nour-massri/fpga-bpf/README.md

# 6.2050 Fall 2025 Final Project

TODO:

- Add video link + pictures
- Summarize the pdf write-up into a readme
- Clean up testsing framework
- Fully pipelined bpf cpu with full capabilities
