nour-massri/fpga-bpf/sim/ultimate_test_pass_clause_1.txt

00
11
22
33
44
55
66
77
88
99
aa
bb
08
00
45
00
00
30
00
01
00
00
40
06
b7
e3
0a
1d
cb
84
0a
44
39
28
30
39
01
bb
00
00
00
01
00
00
00
00
50
02
72
10
00
00
00
00
aa
bb
cc
dd
01
01
02
03
04
