nour-massri/fpga-bpf/xdc/top_level.xdc

# clk_100mhz is from the 100 MHz oscillator on Urbana Boad

set_property -dict {PACKAGE_PIN N15 IOSTANDARD LVCMOS33} [get_ports {clk_100mhz}]
create_clock -add -name gclk -period 10.000 -waveform {0 4} [get_ports {clk_100mhz}]

# Set Bank 0 voltage
#set_property CFGBVS VCCO [current_design]
#set_property CONFIG_VOLTAGE 3.3 [current_design]
# new for week 6: avoid having Vivado freak out about clock domain crossing!

# set_max_delay -datapath_only 6 -from  [get_clocks clk_pixel_cw_hdmi] -to [get_clocks clk_50mhz_unbuf]
# set_max_delay -datapath_only 6 -from  [get_clocks clk_50mhz_unbuf] -to [get_clocks clk_pixel_cw_hdmi]


# USER GREEN LEDS
set_property -dict {PACKAGE_PIN C13  IOSTANDARD LVCMOS33} [ get_ports {led[0]} ]
set_property -dict {PACKAGE_PIN C14  IOSTANDARD LVCMOS33} [ get_ports {led[1]} ]
set_property -dict {PACKAGE_PIN D14  IOSTANDARD LVCMOS33} [ get_ports {led[2]} ]
set_property -dict {PACKAGE_PIN D15  IOSTANDARD LVCMOS33} [ get_ports {led[3]} ]
set_property -dict {PACKAGE_PIN D16  IOSTANDARD LVCMOS33} [ get_ports {led[4]} ]
set_property -dict {PACKAGE_PIN F18  IOSTANDARD LVCMOS33} [ get_ports {led[5]} ]
set_property -dict {PACKAGE_PIN E17  IOSTANDARD LVCMOS33} [ get_ports {led[6]} ]
set_property -dict {PACKAGE_PIN D17  IOSTANDARD LVCMOS33} [ get_ports {led[7]} ]
set_property -dict {PACKAGE_PIN C17  IOSTANDARD LVCMOS33} [ get_ports {led[8]} ]
set_property -dict {PACKAGE_PIN B18  IOSTANDARD LVCMOS33} [ get_ports {led[9]} ]
set_property -dict {PACKAGE_PIN A17  IOSTANDARD LVCMOS33} [ get_ports {led[10]} ]
set_property -dict {PACKAGE_PIN B17  IOSTANDARD LVCMOS33} [ get_ports {led[11]} ]
set_property -dict {PACKAGE_PIN C18  IOSTANDARD LVCMOS33} [ get_ports {led[12]} ]
set_property -dict {PACKAGE_PIN D18  IOSTANDARD LVCMOS33} [ get_ports {led[13]} ]
set_property -dict {PACKAGE_PIN E18  IOSTANDARD LVCMOS33} [ get_ports {led[14]} ]
set_property -dict {PACKAGE_PIN G17  IOSTANDARD LVCMOS33} [ get_ports {led[15]} ]


set_property -dict {PACKAGE_PIN C9 IOSTANDARD LVCMOS33} [get_ports {rgb0[0]}];
set_property -dict {PACKAGE_PIN A9 IOSTANDARD LVCMOS33} [get_ports {rgb0[1]}];
set_property -dict {PACKAGE_PIN A10 IOSTANDARD LVCMOS33} [get_ports {rgb0[2]}];
set_property -dict {PACKAGE_PIN A11 IOSTANDARD LVCMOS33} [get_ports {rgb1[0]}];
set_property -dict {PACKAGE_PIN C10 IOSTANDARD LVCMOS33} [get_ports {rgb1[1]}];
set_property -dict {PACKAGE_PIN B11 IOSTANDARD LVCMOS33} [get_ports {rgb1[2]}];

## USER PUSH BUTTON
set_property -dict {PACKAGE_PIN J2  IOSTANDARD LVCMOS33} [ get_ports "btn[0]" ]
set_property -dict {PACKAGE_PIN J1  IOSTANDARD LVCMOS33} [ get_ports "btn[1]" ]
set_property -dict {PACKAGE_PIN G2  IOSTANDARD LVCMOS33} [ get_ports "btn[2]" ]
set_property -dict {PACKAGE_PIN H2  IOSTANDARD LVCMOS33} [ get_ports "btn[3]" ]

## USER SLIDE SWITCH
set_property -dict {PACKAGE_PIN G1  IOSTANDARD LVCMOS33} [ get_ports "sw[0]" ]
set_property -dict {PACKAGE_PIN F2  IOSTANDARD LVCMOS33} [ get_ports "sw[1]" ]
set_property -dict {PACKAGE_PIN F1  IOSTANDARD LVCMOS33} [ get_ports "sw[2]" ]
set_property -dict {PACKAGE_PIN E2  IOSTANDARD LVCMOS33} [ get_ports "sw[3]" ]
set_property -dict {PACKAGE_PIN E1  IOSTANDARD LVCMOS33} [ get_ports "sw[4]" ]
set_property -dict {PACKAGE_PIN D2  IOSTANDARD LVCMOS33} [ get_ports "sw[5]" ]
set_property -dict {PACKAGE_PIN D1  IOSTANDARD LVCMOS33} [ get_ports "sw[6]" ]
set_property -dict {PACKAGE_PIN C2  IOSTANDARD LVCMOS33} [ get_ports "sw[7]" ]
set_property -dict {PACKAGE_PIN B2  IOSTANDARD LVCMOS33} [ get_ports "sw[8]" ]
set_property -dict {PACKAGE_PIN A4  IOSTANDARD LVCMOS33} [ get_ports "sw[9]" ]
set_property -dict {PACKAGE_PIN A5  IOSTANDARD LVCMOS33} [ get_ports "sw[10]" ]
set_property -dict {PACKAGE_PIN A6  IOSTANDARD LVCMOS33} [ get_ports "sw[11]" ]
set_property -dict {PACKAGE_PIN C7  IOSTANDARD LVCMOS33} [ get_ports "sw[12]" ]
set_property -dict {PACKAGE_PIN A7  IOSTANDARD LVCMOS33} [ get_ports "sw[13]" ]
set_property -dict {PACKAGE_PIN B7  IOSTANDARD LVCMOS33} [ get_ports "sw[14]" ]
set_property -dict {PACKAGE_PIN A8  IOSTANDARD LVCMOS33} [ get_ports "sw[15]" ]

## USER SEVEN SEGMENT DISPLAY HIGH SIDE DRIVE ACTIVE LOW
set_property -dict {PACKAGE_PIN B3  IOSTANDARD LVCMOS33} [ get_ports "ss0_an[0]"]
set_property -dict {PACKAGE_PIN C3  IOSTANDARD LVCMOS33} [ get_ports "ss0_an[1]"]
set_property -dict {PACKAGE_PIN H6  IOSTANDARD LVCMOS33} [ get_ports "ss0_an[2]"]
set_property -dict {PACKAGE_PIN G6  IOSTANDARD LVCMOS33} [ get_ports "ss0_an[3]"]

set_property -dict {PACKAGE_PIN H5  IOSTANDARD LVCMOS33} [ get_ports "ss1_an[0]"]
set_property -dict {PACKAGE_PIN F5  IOSTANDARD LVCMOS33} [ get_ports "ss1_an[1]"]
set_property -dict {PACKAGE_PIN E3  IOSTANDARD LVCMOS33} [ get_ports "ss1_an[2]"]
set_property -dict {PACKAGE_PIN E4  IOSTANDARD LVCMOS33} [ get_ports "ss1_an[3]"]

## USER SEVEN SEGMENT DISPLAY LOW SIDE DRIVE ACTIVE LOW
set_property -dict {PACKAGE_PIN E6  IOSTANDARD LVCMOS33} [ get_ports "ss0_c[0]"]
set_property -dict {PACKAGE_PIN B4  IOSTANDARD LVCMOS33} [ get_ports "ss0_c[1]"]
set_property -dict {PACKAGE_PIN D5  IOSTANDARD LVCMOS33} [ get_ports "ss0_c[2]"]
set_property -dict {PACKAGE_PIN C5  IOSTANDARD LVCMOS33} [ get_ports "ss0_c[3]"]
set_property -dict {PACKAGE_PIN D7  IOSTANDARD LVCMOS33} [ get_ports "ss0_c[4]"]
set_property -dict {PACKAGE_PIN D6  IOSTANDARD LVCMOS33} [ get_ports "ss0_c[5]"]
set_property -dict {PACKAGE_PIN C4  IOSTANDARD LVCMOS33} [ get_ports "ss0_c[6]"]
# set_property -dict {PACKAGE_PIN B5  IOSTANDARD LVCMOS33} [ get_ports "ss0_cdp"]

set_property -dict {PACKAGE_PIN F3  IOSTANDARD LVCMOS33} [ get_ports "ss1_c[0]"]
set_property -dict {PACKAGE_PIN G5  IOSTANDARD LVCMOS33} [ get_ports "ss1_c[1]"]
set_property -dict {PACKAGE_PIN J3  IOSTANDARD LVCMOS33} [ get_ports "ss1_c[2]"]
set_property -dict {PACKAGE_PIN H4  IOSTANDARD LVCMOS33} [ get_ports "ss1_c[3]"]
set_property -dict {PACKAGE_PIN F4  IOSTANDARD LVCMOS33} [ get_ports "ss1_c[4]"]
set_property -dict {PACKAGE_PIN H3  IOSTANDARD LVCMOS33} [ get_ports "ss1_c[5]"]
set_property -dict {PACKAGE_PIN E5  IOSTANDARD LVCMOS33} [ get_ports "ss1_c[6]"]
# set_property -dict {PACKAGE_PIN J4  IOSTANDARD LVCMOS33} [ get_ports "ss1_c[7]"]


# PMOD A Signals
 
set_property -dict {PACKAGE_PIN F14 IOSTANDARD LVCMOS33}  [ get_ports "eth2_txd[0]" ] 
set_property -dict {PACKAGE_PIN F15 IOSTANDARD LVCMOS33}  [ get_ports "eth2_rxd[1]" ] 
set_property -dict {PACKAGE_PIN H13 IOSTANDARD LVCMOS33}  [ get_ports "eth2_crsdv" ]
# #set_property -dict {PACKAGE_PIN H14 IOSTANDARD LVCMOS33}  [ get_ports "pmoda[3]" ] MOC_eth2
set_property -dict {PACKAGE_PIN J13 IOSTANDARD LVCMOS33}  [ get_ports "eth2_txen" ] 
set_property -dict {PACKAGE_PIN J14 IOSTANDARD LVCMOS33}  [ get_ports "eth2_rxd[0]" ]
set_property -dict {PACKAGE_PIN E14 IOSTANDARD LVCMOS33}  [ get_ports "eth2_clk" ]
# Allow the clock to travel on non-clock routing tracks (Dirt Road)
set_property CLOCK_DEDICATED_ROUTE FALSE [get_nets -of_objects [get_ports "eth2_clk"]]
# #set_property -dict {PACKAGE_PIN E15 IOSTANDARD LVCMOS33}  [ get_ports "pmoda[7]" ] MDIO_eth2
 
# PMOD B Signals
set_property -dict {PACKAGE_PIN H18 IOSTANDARD LVCMOS33}  [ get_ports "eth1_txd[0]" ]
set_property -dict {PACKAGE_PIN G18 IOSTANDARD LVCMOS33}  [ get_ports "eth1_rxd[1]" ]
set_property -dict {PACKAGE_PIN K14 IOSTANDARD LVCMOS33}  [ get_ports "eth1_crsdv" ]
# set_property -dict {PACKAGE_PIN J15 IOSTANDARD LVCMOS33}  [ get_ports "pmodb[3]" ] MOC
set_property -dict {PACKAGE_PIN H16 IOSTANDARD LVCMOS33}  [ get_ports "eth1_txen" ]
set_property -dict {PACKAGE_PIN H17 IOSTANDARD LVCMOS33}  [ get_ports "eth1_rxd[0]" ]
set_property -dict {PACKAGE_PIN K16 IOSTANDARD LVCMOS33}  [ get_ports "eth1_clk" ]
# Allow the clock to travel on non-clock routing tracks (Dirt Road)
set_property CLOCK_DEDICATED_ROUTE FALSE [get_nets -of_objects [get_ports "eth1_clk"]]
# set_property -dict {PACKAGE_PIN J16 IOSTANDARD LVCMOS33}  [ get_ports "pmodb[7]" ] MDIO
 
# PMOD AB Signals
#set_property -dict {PACKAGE_PIN D11 IOSTANDARD LVCMOS33} [get_ports {jab[0]}] NC_eth2
#set_property -dict {PACKAGE_PIN C12 IOSTANDARD LVCMOS33} [get_ports {jab[1]}
# set_property -dict {PACKAGE_PIN E16 IOSTANDARD LVCMOS33} [get_ports {jab[2]}] NC
set_property -dict {PACKAGE_PIN G16 IOSTANDARD LVCMOS33} [get_ports "eth1_txd[1]"]
#set_property -dict {PACKAGE_PIN C11 IOSTANDARD LVCMOS33} [get_ports {jab[4]}]
set_property -dict {PACKAGE_PIN D10 IOSTANDARD LVCMOS33} [get_ports "eth2_txd[1]"]
 
 
#HDMI Signals
set_property -dict { PACKAGE_PIN V17   IOSTANDARD TMDS_33  } [get_ports {hdmi_clk_n}]
set_property -dict { PACKAGE_PIN U16   IOSTANDARD TMDS_33  } [get_ports {hdmi_clk_p}]
set_property -dict { PACKAGE_PIN U18   IOSTANDARD TMDS_33  } [get_ports {hdmi_tx_n[0]}]
set_property -dict { PACKAGE_PIN R17   IOSTANDARD TMDS_33  } [get_ports {hdmi_tx_n[1]}]
set_property -dict { PACKAGE_PIN T14   IOSTANDARD TMDS_33  } [get_ports {hdmi_tx_n[2]}]
set_property -dict { PACKAGE_PIN U17   IOSTANDARD TMDS_33  } [get_ports {hdmi_tx_p[0]}]
set_property -dict { PACKAGE_PIN R16   IOSTANDARD TMDS_33  } [get_ports {hdmi_tx_p[1]}]
set_property -dict { PACKAGE_PIN R14   IOSTANDARD TMDS_33  } [get_ports {hdmi_tx_p[2]}]

# PWM audio out signals
#change G15 to B13 and E13 to B14
#set_property PACKAGE_PIN B13 [ get_ports "spkl"]
#set_property PACKAGE_PIN B14 [ get_ports "spkr"]
#set_property IOSTANDARD LVCMOS33 [ get_ports "spk*"]

# PWM Microphone signals
#set_property -dict {PACKAGE_PIN E12 IOSTANDARD LVCMOS33} [get_ports {mic_clk}]
#set_property -dict {PACKAGE_PIN D12 IOSTANDARD LVCMOS33} [get_ports {mic_data}]



# UART over micro-USB signals
# labeled from the perspective of the FPGA!
# note the inversion from RealDigital official documentation.
#set_property -dict {PACKAGE_PIN B16 IOSTANDARD LVCMOS33} [get_ports {uart_rxd}]
#set_property -dict {PACKAGE_PIN A16 IOSTANDARD LVCMOS33} [get_ports {uart_txd}]


############## NET - IOSTANDARD ##################
### Pins below are for the DDR3
### Remove the first column of comments in one block to activate all appropriate pins

## PadFunction: IO_L1N_T0_34 (SCHEMATIC DDR_DQ0)
#current_instance -quiet
#set_property SLEW FAST [get_ports {ddr3_dq[0]}]
#set_property IN_TERM UNTUNED_SPLIT_50 [get_ports {ddr3_dq[0]}]
#set_property IOSTANDARD SSTL135 [get_ports {ddr3_dq[0]}]
#set_property PACKAGE_PIN K2 [get_ports {ddr3_dq[0]}]
#
## PadFunction: IO_L2P_T0_34 (SCHEMATIC DDR_DQ1)
#set_property SLEW FAST [get_ports {ddr3_dq[1]}]
#set_property IN_TERM UNTUNED_SPLIT_50 [get_ports {ddr3_dq[1]}]
#set_property IOSTANDARD SSTL135 [get_ports {ddr3_dq[1]}]
#set_property PACKAGE_PIN M4 [get_ports {ddr3_dq[1]}]
#
## PadFunction: IO_L2N_T0_34 (SCHEMATIC DDR_DQ2)
#set_property SLEW FAST [get_ports {ddr3_dq[2]}]
#set_property IN_TERM UNTUNED_SPLIT_50 [get_ports {ddr3_dq[2]}]
#set_property IOSTANDARD SSTL135 [get_ports {ddr3_dq[2]}]
#set_property PACKAGE_PIN K3 [get_ports {ddr3_dq[2]}]
#
## PadFunction: IO_L4P_T0_34 (SCHEMATIC DDR_DQ3)
#set_property SLEW FAST [get_ports {ddr3_dq[3]}]
#set_property IN_TERM UNTUNED_SPLIT_50 [get_ports {ddr3_dq[3]}]
#set_property IOSTANDARD SSTL135 [get_ports {ddr3_dq[3]}]
#set_property PACKAGE_PIN L5 [get_ports {ddr3_dq[3]}]
#
## PadFunction: IO_L4N_T0_34 (SCHEMATIC DDR_DQ4)
#set_property SLEW FAST [get_ports {ddr3_dq[4]}]
#set_property IN_TERM UNTUNED_SPLIT_50 [get_ports {ddr3_dq[4]}]
#set_property IOSTANDARD SSTL135 [get_ports {ddr3_dq[4]}]
#set_property PACKAGE_PIN L6 [get_ports {ddr3_dq[4]}]
#
## PadFunction: IO_L5P_T0_34 (SCHEMATIC DDR_DQ5)
#set_property SLEW FAST [get_ports {ddr3_dq[5]}]
#set_property IN_TERM UNTUNED_SPLIT_50 [get_ports {ddr3_dq[5]}]
#set_property IOSTANDARD SSTL135 [get_ports {ddr3_dq[5]}]
#set_property PACKAGE_PIN M6 [get_ports {ddr3_dq[5]}]
#
## PadFunction: IO_L5N_T0_34 (SCHEMATIC DDR_DQ6)
#set_property SLEW FAST [get_ports {ddr3_dq[6]}]
#set_property IN_TERM UNTUNED_SPLIT_50 [get_ports {ddr3_dq[6]}]
#set_property IOSTANDARD SSTL135 [get_ports {ddr3_dq[6]}]
#set_property PACKAGE_PIN L4 [get_ports {ddr3_dq[6]}]
#
## PadFunction: IO_L6P_T0_34 (SCHEMATIC DDR_DQ7)
#set_property SLEW FAST [get_ports {ddr3_dq[7]}]
#set_property IN_TERM UNTUNED_SPLIT_50 [get_ports {ddr3_dq[7]}]
#set_property IOSTANDARD SSTL135 [get_ports {ddr3_dq[7]}]
#set_property PACKAGE_PIN K6 [get_ports {ddr3_dq[7]}]
#
## PadFunction: IO_L7N_T1_34 (SCHEMATIC DDR_DQ8)
#set_property SLEW FAST [get_ports {ddr3_dq[8]}]
#set_property IN_TERM UNTUNED_SPLIT_50 [get_ports {ddr3_dq[8]}]
#set_property IOSTANDARD SSTL135 [get_ports {ddr3_dq[8]}]
#set_property PACKAGE_PIN N5 [get_ports {ddr3_dq[8]}]
#
## PadFunction: IO_L8P_T1_34 (SCHEMATIC DDR_DQ9)
#set_property SLEW FAST [get_ports {ddr3_dq[9]}]
#set_property IN_TERM UNTUNED_SPLIT_50 [get_ports {ddr3_dq[9]}]
#set_property IOSTANDARD SSTL135 [get_ports {ddr3_dq[9]}]
#set_property PACKAGE_PIN M1 [get_ports {ddr3_dq[9]}]
#
## PadFunction: IO_L8N_T1_34 (SCHEMATIC DDR_DQ10)
#set_property SLEW FAST [get_ports {ddr3_dq[10]}]
#set_property IN_TERM UNTUNED_SPLIT_50 [get_ports {ddr3_dq[10]}]
#set_property IOSTANDARD SSTL135 [get_ports {ddr3_dq[10]}]
#set_property PACKAGE_PIN P1 [get_ports {ddr3_dq[10]}]
#
## PadFunction: IO_L10P_T1_34 (SCHEMATIC DDR_DQ11)
#set_property SLEW FAST [get_ports {ddr3_dq[11]}]
#set_property IN_TERM UNTUNED_SPLIT_50 [get_ports {ddr3_dq[11]}]
#set_property IOSTANDARD SSTL135 [get_ports {ddr3_dq[11]}]
#set_property PACKAGE_PIN N1 [get_ports {ddr3_dq[11]}]
#
## PadFunction: IO_L10N_T1_34 (SCHEMATIC DDR_DQ12)
#set_property SLEW FAST [get_ports {ddr3_dq[12]}]
#set_property IN_TERM UNTUNED_SPLIT_50 [get_ports {ddr3_dq[12]}]
#set_property IOSTANDARD SSTL135 [get_ports {ddr3_dq[12]}]
#set_property PACKAGE_PIN R2 [get_ports {ddr3_dq[12]}]
#
## PadFunction: IO_L11P_T1_SRCC_34 (SCHEMATIC DDR_DQ13)
#set_property SLEW FAST [get_ports {ddr3_dq[13]}]
#set_property IN_TERM UNTUNED_SPLIT_50 [get_ports {ddr3_dq[13]}]
#set_property IOSTANDARD SSTL135 [get_ports {ddr3_dq[13]}]
#set_property PACKAGE_PIN N4 [get_ports {ddr3_dq[13]}]
#
## PadFunction: IO_L11N_T1_SRCC_34 (SCHEMATIC DDR_DQ14)
#set_property SLEW FAST [get_ports {ddr3_dq[14]}]
#set_property IN_TERM UNTUNED_SPLIT_50 [get_ports {ddr3_dq[14]}]
#set_property IOSTANDARD SSTL135 [get_ports {ddr3_dq[14]}]
#set_property PACKAGE_PIN P2 [get_ports {ddr3_dq[14]}]
#
## PadFunction: IO_L12P_T1_MRCC_34 (SCHEMATIC DDR_DQ15)
#set_property SLEW FAST [get_ports {ddr3_dq[15]}]
#set_property IN_TERM UNTUNED_SPLIT_50 [get_ports {ddr3_dq[15]}]
#set_property IOSTANDARD SSTL135 [get_ports {ddr3_dq[15]}]
#set_property PACKAGE_PIN M2 [get_ports {ddr3_dq[15]}]
#
## PadFunction: IO_L13P_T2_MRCC_34 (SCHEMATIC DDR_A14)
##set_property SLEW FAST [get_ports {ddr3_addr[14]}]
##set_property IOSTANDARD SSTL135 [get_ports {ddr3_addr[14]}]
##set_property PACKAGE_PIN R6 [get_ports {ddr3_addr[14]}]
#
## PadFunction: IO_L13N_T2_MRCC_34 (SCHEMATIC DDR_A13)
##set_property SLEW FAST [get_ports {ddr3_addr[13]}]
##set_property IOSTANDARD SSTL135 [get_ports {ddr3_addr[13]}]
##set_property PACKAGE_PIN V7 [get_ports {ddr3_addr[13]}]
#
## PadFunction: IO_L14P_T2_SRCC_34 (SCHEMATIC DDR_A12)
#set_property SLEW FAST [get_ports {ddr3_addr[12]}]
#set_property IOSTANDARD SSTL135 [get_ports {ddr3_addr[12]}]
#set_property PACKAGE_PIN V6 [get_ports {ddr3_addr[12]}]
#
## PadFunction: IO_L14N_T2_SRCC_34 (SCHEMATIC DDR_A11)
#set_property SLEW FAST [get_ports {ddr3_addr[11]}]
#set_property IOSTANDARD SSTL135 [get_ports {ddr3_addr[11]}]
#set_property PACKAGE_PIN P5 [get_ports {ddr3_addr[11]}]
#
## PadFunction: IO_L15P_T2_DQS_34 (SCHEMATIC DDR_A10)
#set_property SLEW FAST [get_ports {ddr3_addr[10]}]
#set_property IOSTANDARD SSTL135 [get_ports {ddr3_addr[10]}]
#set_property PACKAGE_PIN U3 [get_ports {ddr3_addr[10]}]
#
## PadFunction: IO_L15N_T2_DQS_34 (SCHEMATIC DDR_A9)
#set_property SLEW FAST [get_ports {ddr3_addr[9]}]
#set_property IOSTANDARD SSTL135 [get_ports {ddr3_addr[9]}]
#set_property PACKAGE_PIN U6 [get_ports {ddr3_addr[9]}]
#
## PadFunction: IO_L16P_T2_34 (SCHEMATIC DDR_A8)
#set_property SLEW FAST [get_ports {ddr3_addr[8]}]
#set_property IOSTANDARD SSTL135 [get_ports {ddr3_addr[8]}]
#set_property PACKAGE_PIN R7 [get_ports {ddr3_addr[8]}]
#
## PadFunction: IO_L16N_T2_34 (SCHEMATIC DDR_A7)
#set_property SLEW FAST [get_ports {ddr3_addr[7]}]
#set_property IOSTANDARD SSTL135 [get_ports {ddr3_addr[7]}]
#set_property PACKAGE_PIN U7 [get_ports {ddr3_addr[7]}]
#
## PadFunction: IO_L17P_T2_34 (SCHEMATIC DDR_A6)
#set_property SLEW FAST [get_ports {ddr3_addr[6]}]
#set_property IOSTANDARD SSTL135 [get_ports {ddr3_addr[6]}]
#set_property PACKAGE_PIN V5 [get_ports {ddr3_addr[6]}]
#
## PadFunction: IO_L17N_T2_34 (SCHEMATIC DDR_A5)
#set_property SLEW FAST [get_ports {ddr3_addr[5]}]
#set_property IOSTANDARD SSTL135 [get_ports {ddr3_addr[5]}]
#set_property PACKAGE_PIN T1 [get_ports {ddr3_addr[5]}]
#
## PadFunction: IO_L18P_T2_34 (SCHEMATIC DDR_A4)
#set_property SLEW FAST [get_ports {ddr3_addr[4]}]
#set_property IOSTANDARD SSTL135 [get_ports {ddr3_addr[4]}]
#set_property PACKAGE_PIN T6 [get_ports {ddr3_addr[4]}]
#
## PadFunction: IO_L18N_T2_34 (SCHEMATIC DDR_A3)
#set_property SLEW FAST [get_ports {ddr3_addr[3]}]
#set_property IOSTANDARD SSTL135 [get_ports {ddr3_addr[3]}]
#set_property PACKAGE_PIN T3 [get_ports {ddr3_addr[3]}]
#
## PadFunction: IO_L19P_T3_34 (SCHEMATIC DDR_A2)
#set_property SLEW FAST [get_ports {ddr3_addr[2]}]
#set_property IOSTANDARD SSTL135 [get_ports {ddr3_addr[2]}]
#set_property PACKAGE_PIN P6 [get_ports {ddr3_addr[2]}]
#
## PadFunction: IO_L19N_T3_VREF_34 (SCHEMATIC DDR_A1)
#set_property SLEW FAST [get_ports {ddr3_addr[1]}]
#set_property IOSTANDARD SSTL135 [get_ports {ddr3_addr[1]}]
#set_property PACKAGE_PIN R4 [get_ports {ddr3_addr[1]}]
#
## PadFunction: IO_L20P_T3_34 (SCHEMATIC DDR_A0)
#set_property SLEW FAST [get_ports {ddr3_addr[0]}]
#set_property IOSTANDARD SSTL135 [get_ports {ddr3_addr[0]}]
#set_property PACKAGE_PIN V3 [get_ports {ddr3_addr[0]}]
#
## PadFunction: IO_L20N_T3_34 (SCHEMATIC DDR_BA2)
#set_property SLEW FAST [get_ports {ddr3_ba[2]}]
#set_property IOSTANDARD SSTL135 [get_ports {ddr3_ba[2]}]
#set_property PACKAGE_PIN R3 [get_ports {ddr3_ba[2]}]
#
## PadFunction: IO_L22P_T3_34 (SCHEMATIC DDR_BA1)
#set_property SLEW FAST [get_ports {ddr3_ba[1]}]
#set_property IOSTANDARD SSTL135 [get_ports {ddr3_ba[1]}]
#set_property PACKAGE_PIN V4 [get_ports {ddr3_ba[1]}]
#
## PadFunction: IO_L22N_T3_34 (SCHEMATIC DDR_BA0)
#set_property SLEW FAST [get_ports {ddr3_ba[0]}]
#set_property IOSTANDARD SSTL135 [get_ports {ddr3_ba[0]}]
#set_property PACKAGE_PIN V2 [get_ports {ddr3_ba[0]}]
#
## PadFunction: IO_L23P_T3_34 (SCHEMATIC DDR_RAS_B
#set_property SLEW FAST [get_ports ddr3_ras_n]
#set_property IOSTANDARD SSTL135 [get_ports ddr3_ras_n]
#set_property PACKAGE_PIN U2 [get_ports ddr3_ras_n]
#
## PadFunction: IO_L23N_T3_34 (SCHEMATIC DDR_CAS_B)
#set_property SLEW FAST [get_ports ddr3_cas_n]
#set_property IOSTANDARD SSTL135 [get_ports ddr3_cas_n]
#set_property PACKAGE_PIN U1 [get_ports ddr3_cas_n]
#
## PadFunction: IO_L24P_T3_34 (SCHEMATIC DDR_WE_B)
#set_property SLEW FAST [get_ports ddr3_we_n]
#set_property IOSTANDARD SSTL135 [get_ports ddr3_we_n]
#set_property PACKAGE_PIN T2 [get_ports ddr3_we_n]
#
## PadFunction: IO_L6N_T0_VREF_34 (SCHEMATIC DDR_RESET_B)
#set_property SLEW FAST [get_ports ddr3_reset_n]
#set_property IOSTANDARD SSTL135 [get_ports ddr3_reset_n]
#set_property PACKAGE_PIN M5 [get_ports ddr3_reset_n]
#
## PadFunction: IO_L24N_T3_34 (SCHEMATIC DDR_CKE)
#set_property SLEW FAST [get_ports {ddr3_cke[0]}]
#set_property IOSTANDARD SSTL135 [get_ports {ddr3_cke[0]}]
#set_property PACKAGE_PIN T5 [get_ports {ddr3_cke[0]}]
#
## PadFunction: IO_25_34 (SCHEMATIC DDR_ODT)
#set_property SLEW FAST [get_ports {ddr3_odt[0]}]
#set_property IOSTANDARD SSTL135 [get_ports {ddr3_odt[0]}]
#set_property PACKAGE_PIN P7 [get_ports {ddr3_odt[0]}]
#
## PadFunction: IO_L1P_T0_34 (SCHEMATIC DDR_LDM)
#set_property SLEW FAST [get_ports {ddr3_dm[0]}]
#set_property IOSTANDARD SSTL135 [get_ports {ddr3_dm[0]}]
#set_property PACKAGE_PIN K4 [get_ports {ddr3_dm[0]}]
#
## PadFunction: IO_L7P_T1_34 (SCHEMATIC DDR_UDM)
#set_property SLEW FAST [get_ports {ddr3_dm[1]}]
#set_property IOSTANDARD SSTL135 [get_ports {ddr3_dm[1]}]
#set_property PACKAGE_PIN M3 [get_ports {ddr3_dm[1]}]
#
## PadFunction: IO_L3P_T0_DQS_34 (SCHEMATIC DDR_LDQS_P)
#set_property SLEW FAST [get_ports {ddr3_dqs_p[0]}]
#set_property IN_TERM UNTUNED_SPLIT_50 [get_ports {ddr3_dqs_p[0]}]
#set_property IOSTANDARD DIFF_SSTL135 [get_ports {ddr3_dqs_p[0]}]
#
## PadFunction: IO_L3N_T0_DQS_34 (SCHEMATIC DDR_LDQS_N)
#set_property SLEW FAST [get_ports {ddr3_dqs_n[0]}]
#set_property IN_TERM UNTUNED_SPLIT_50 [get_ports {ddr3_dqs_n[0]}]
#set_property IOSTANDARD DIFF_SSTL135 [get_ports {ddr3_dqs_n[0]}]
#set_property PACKAGE_PIN K1 [get_ports {ddr3_dqs_p[0]}]
#set_property PACKAGE_PIN L1 [get_ports {ddr3_dqs_n[0]}]
#
## PadFunction: IO_L9P_T1_DQS_34 (SCHEMATIC DDR_UDQS_P)
#set_property SLEW FAST [get_ports {ddr3_dqs_p[1]}]
#set_property IN_TERM UNTUNED_SPLIT_50 [get_ports {ddr3_dqs_p[1]}]
#set_property IOSTANDARD DIFF_SSTL135 [get_ports {ddr3_dqs_p[1]}]
#
## PadFunction: IO_L9N_T1_DQS_34 (SCHEMATIC DDR_UDQS_N)
#set_property SLEW FAST [get_ports {ddr3_dqs_n[1]}]
#set_property IN_TERM UNTUNED_SPLIT_50 [get_ports {ddr3_dqs_n[1]}]
#set_property IOSTANDARD DIFF_SSTL135 [get_ports {ddr3_dqs_n[1]}]
#set_property PACKAGE_PIN N3 [get_ports {ddr3_dqs_p[1]}]
#set_property PACKAGE_PIN N2 [get_ports {ddr3_dqs_n[1]}]
#
## PadFunction: IO_L21P_T3_DQS_34 (SCHEMATIC DDR_CLK_P)
#set_property SLEW FAST [get_ports {ddr3_ck_p[0]}]
#set_property IOSTANDARD DIFF_SSTL135 [get_ports {ddr3_ck_p[0]}]
#
## PadFunction: IO_L21N_T3_DQS_34 (SCHEMATIC DDR_CLK_N)
#set_property SLEW FAST [get_ports {ddr3_ck_n[0]}]
#set_property IOSTANDARD DIFF_SSTL135 [get_ports {ddr3_ck_n[0]}]
#set_property PACKAGE_PIN R5 [get_ports {ddr3_ck_p[0]}]
#set_property PACKAGE_PIN T4 [get_ports {ddr3_ck_n[0]}]


# GLOBAL CONFIGURATIONS

set_property BITSTREAM.CONFIG.UNUSEDPIN PULLUP [current_design]
set_property BITSTREAM.GENERAL.COMPRESS TRUE [current_design]

#set_property INTERNAL_VREF 0.675 [get_iobanks 34]
#set_property CFGBVS VCCO [current_design]
#set_property CONFIG_VOLTAGE 3.3 [current_design]
