nour-massri/fpga-bpf/hdl/display_controller/tmds_encoder.sv

`timescale 1ns / 1ps `default_nettype none

module tmds_encoder (
    input wire clk,
    input wire rst,
    input wire [7:0] video_data,  // video data (red, green or blue)
    input wire [1:0] control,  //for blue set to {vs,hs}, else will be 0
    input wire video_enable,  //choose between control (0) or video (1)
    output logic [9:0] tmds
);
  logic [8:0] q_m;

  tm_choice mtm (
      .d  (video_data),
      .q_m(q_m)
  );

  //your code here.
  logic [4:0] tally;
  logic [3:0] ones_count, zeros_count;
  always_comb begin
    ones_count  = q_m[0] + q_m[1] + q_m[2] + q_m[3] + q_m[4] + q_m[5] + q_m[6] + q_m[7];
    zeros_count = 4'd8 - ones_count;
  end


  always_ff @(posedge clk) begin
    if (rst) begin
      tally <= 0;
      tmds  <= 0;
    end else begin
      if (!video_enable) begin
        tally <= 0;
        case (control)
          2'b00: tmds <= 10'b1101010100;
          2'b01: tmds <= 10'b0010101011;
          2'b10: tmds <= 10'b0101010100;
          2'b11: tmds <= 10'b1010101011;
        endcase
      end else begin
        if (tally == 0 || (ones_count == zeros_count)) begin
          tmds[9] <= ~q_m[8];
          tmds[8] <= q_m[8];
          if (q_m[8] == 0) begin
            tmds[7:0] <= ~q_m[7:0];
            tally <= tally + zeros_count - ones_count;
          end else begin
            tmds[7:0] <= q_m[7:0];
            tally <= tally + ones_count - zeros_count;
          end
        end else begin
          if((tally[4] == 1'b0 && ones_count > zeros_count) || (tally[4] == 1'b1 && zeros_count > ones_count)) begin
            tmds[9] <= 1;
            tmds[8] <= q_m[8];
            tmds[7:0] <= ~q_m[7:0];
            tally <= tally + {q_m[8], 1'b0} + (zeros_count - ones_count);
          end else begin
            tmds[9] <= 0;
            tmds[8] <= q_m[8];
            tmds[7:0] <= q_m[7:0];
            tally <= tally - {~q_m[8], 1'b0} + (ones_count - zeros_count);
          end
        end
      end
    end
  end
endmodule

`default_nettype wire
