nour-massri/fpga-bpf/hdl/display_controller/vsg.sv

`timescale 1ns / 1ps `default_nettype none

module video_sig_gen #(
    parameter ACTIVE_H_PIXELS = 1280,
    parameter H_FRONT_PORCH = 110,
    parameter H_SYNC_WIDTH = 40,
    parameter H_BACK_PORCH = 220,
    parameter ACTIVE_LINES = 720,
    parameter V_FRONT_PORCH = 5,
    parameter V_SYNC_WIDTH = 5,
    parameter V_BACK_PORCH = 20,
    parameter FPS = 60
) (
    input wire pixel_clk,
    input wire rst,
    output logic [$clog2(
ACTIVE_H_PIXELS + H_FRONT_PORCH + H_SYNC_WIDTH + H_BACK_PORCH
)-1:0] h_count,
    output logic [$clog2(ACTIVE_LINES + V_FRONT_PORCH + V_SYNC_WIDTH + V_BACK_PORCH)-1:0] v_count,
    output logic v_sync,
    output logic h_sync,
    output logic active_draw,
    output logic new_frame,
    output logic [5:0] frame_count
);

  localparam TOTAL_PIXELS = ACTIVE_H_PIXELS + H_FRONT_PORCH + H_SYNC_WIDTH + H_BACK_PORCH;
  localparam TOTAL_LINES = ACTIVE_LINES + V_FRONT_PORCH + V_SYNC_WIDTH + V_BACK_PORCH;

  always_ff @(posedge pixel_clk) begin
    if (rst) begin
      h_count <= 0;
      v_count <= 0;
      frame_count <= 0;
    end else begin
      if (h_count == ACTIVE_H_PIXELS - 1 && v_count == ACTIVE_LINES - 1) begin
        if (frame_count == FPS - 1) begin
          frame_count <= 0;
        end else begin
          frame_count <= frame_count + 1;
        end
      end
      if (h_count == TOTAL_PIXELS - 1) begin
        h_count <= 0;
        if (v_count == TOTAL_LINES - 1) begin
          v_count <= 0;
        end else begin
          v_count <= v_count + 1;
        end
      end else begin
        h_count <= h_count + 1;
      end
    end
  end

  always_comb begin
    h_sync = !rst && (h_count >= ACTIVE_H_PIXELS + H_FRONT_PORCH) && 
             (h_count < ACTIVE_H_PIXELS + H_FRONT_PORCH + H_SYNC_WIDTH);

    v_sync = !rst && (v_count >= ACTIVE_LINES + V_FRONT_PORCH) && 
             (v_count < ACTIVE_LINES + V_FRONT_PORCH + V_SYNC_WIDTH);

    active_draw = !rst && (h_count < ACTIVE_H_PIXELS) && (v_count < ACTIVE_LINES);

    new_frame = !rst && (h_count == ACTIVE_H_PIXELS) && (v_count == ACTIVE_LINES - 1);
  end

endmodule
`default_nettype wire
