nour-massri/fpga-bpf/hdl/utils/fifo/async_init_fifo.sv

`timescale 1ns / 1ps `default_nettype none

module async_init_fifo #(
    parameter int DATA_WIDTH = 8,
    parameter int FIFO_DEPTH = 16,
    parameter int INIT_COUNT = 0
) (
    input wire rst,

    // Push side
    input wire push_clk,
    input wire [DATA_WIDTH-1:0] i_push_data,
    input wire i_push_valid,
    output logic o_push_ready,

    // Pop side 
    input wire pop_clk,
    output logic [DATA_WIDTH-1:0] o_pop_data,
    output logic o_pop_valid,
    input wire i_pop_ready
);

  logic [DATA_WIDTH-1:0] internal_push_data;
  logic internal_push_valid;
  logic internal_push_ready;

  async_fifo #(
      .DATA_WIDTH(DATA_WIDTH),
      .FIFO_DEPTH(FIFO_DEPTH)
  ) transport_fifo (
      .rst(rst),

      .push_clk(push_clk),
      .i_push_data(i_push_data),
      .i_push_valid(i_push_valid),
      .o_push_ready(o_push_ready),

      .pop_clk(pop_clk),
      .o_pop_data(internal_push_data),
      .o_pop_valid(internal_push_valid),
      .i_pop_ready(internal_push_ready)
  );

  fifo #(
      .DATA_WIDTH(DATA_WIDTH),
      .FIFO_DEPTH(FIFO_DEPTH),
      .INIT_COUNT(INIT_COUNT)
  ) storage_fifo (
      .clk(pop_clk),
      .rst(rst),

      .i_push_data (internal_push_data),
      .i_push_valid(internal_push_valid),
      .o_push_ready(internal_push_ready),

      .o_pop_data (o_pop_data),
      .o_pop_valid(o_pop_valid),
      .i_pop_ready(i_pop_ready)
  );
endmodule
`default_nettype wire
