nour-massri/fpga-bpf/(commit log)

2025-11-12 New top level, takes in input from second ethernet cable
2025-11-13 skeleton for traffic filter
2025-11-27 integrating display + bpf_processor + cpu skeleton + fixing clk for network_bpf to all use eth1_clk
    [bpf_cpu.sv, bpf_processor.sv, display_controller.sv, eth_rx.sv, eth_tx.sv, evt_counter.sv, network_bpf.sv, rmii_to_byte.sv]
2025-11-29 adding uart from lab03
2025-12-02 found the damn bug I hate svh files
    [bram_demux_read.sv, network_bpf.sv]
2025-12-08 Packets are displayed from ethernet / fixed display bug
    [display_controller.sv, top_level.sv]
2025-12-09 fixed comb cpu_start still doens't work tho
    [bpf_cpu.sv, bpf_processor.sv]
2025-12-09 fixed it is .mem issue
    [bpf_cpu.sv, network_bpf_config_pkg.sv]
2025-12-09 fixes + streaming2 that doesn't mhs
    [bpf_cpu.sv]
2025-12-10 display dropped count + fix bpf_cpu x prop
    [bpf_cpu.sv, eth_rx.sv, eth_tx.sv, network_bpf.sv, network_bpf_statistics.sv, top_level.sv]
